colinwang2007/Shaft-Collar-Design-for-Thunderbots/Photos Shaft Collar.pdf

# Final Design CAD photos

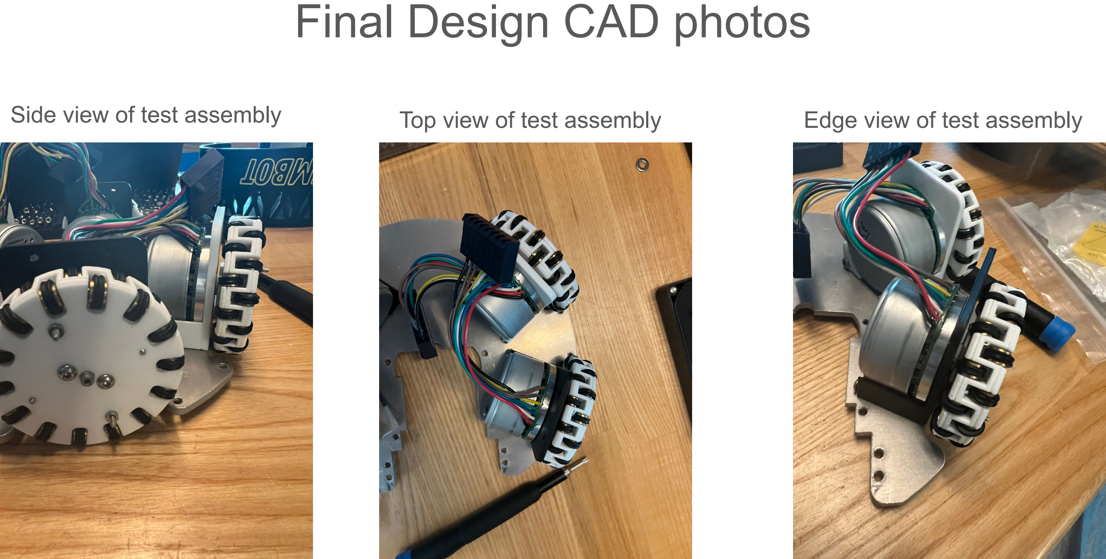
[picture p10: page 1]

Side view of test assembly | Top view of test assembly | Edge view of test assembly

# Final Design CAD photos

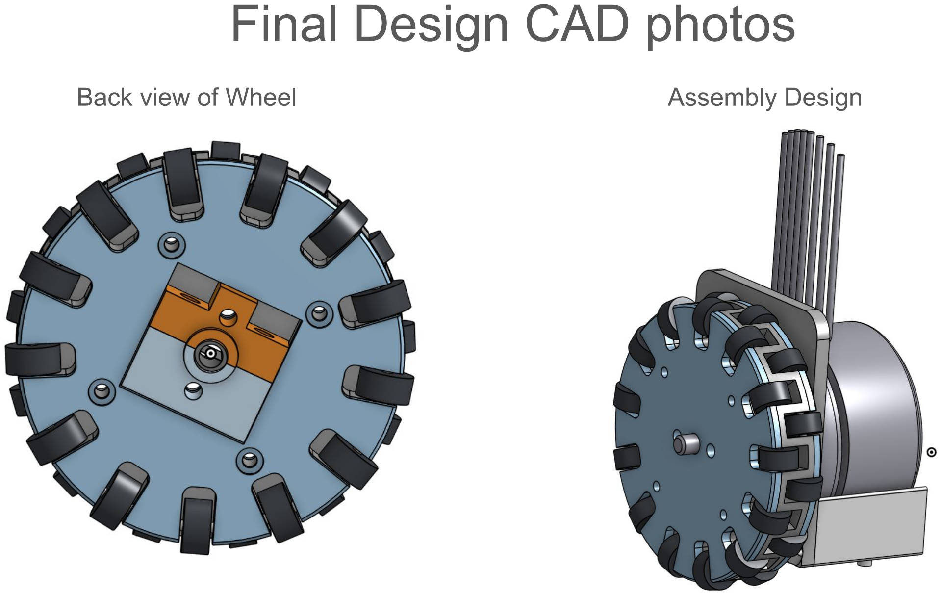
[picture p11: page 2]

Back view of Wheel

Assembly Design

# Old Design Photos

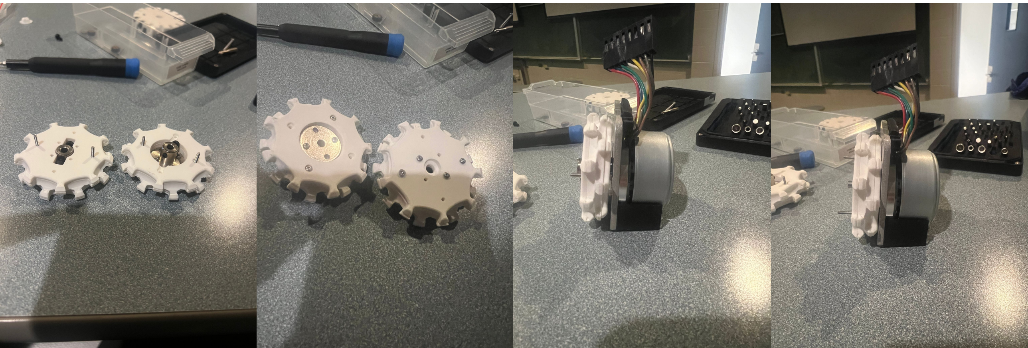
[picture p12: figure]
