colinwang2007/Shaft-Collar-Design-for-Thunderbots/CAD Models/57mm Final Wheel - Center.stl

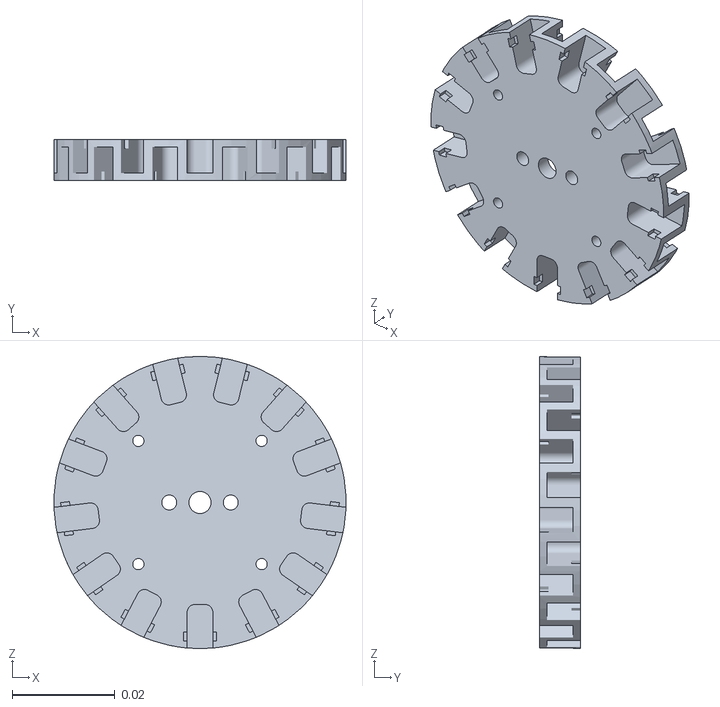
[picture p13: CAD file, 2026-03-01]
CAD Models/57mm Final Wheel - Center.stl
0.057 x 0.008 x 0.057
