colinwang2007/Shaft-Collar-Design-for-Thunderbots/CAD Models/57mm Final Wheel - Top.stl

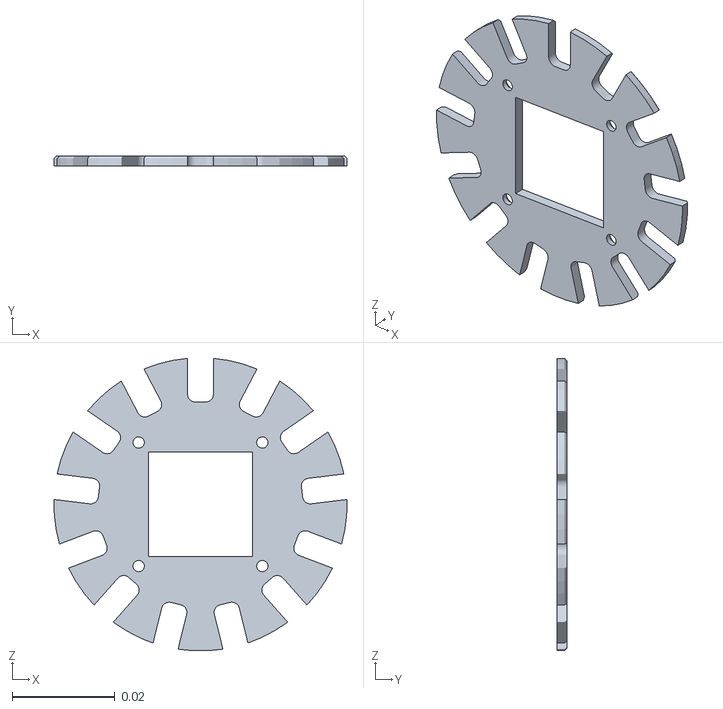
[picture p16: CAD file, 2026-03-01]
CAD Models/57mm Final Wheel - Top.stl
0.057 x 0.002 x 0.0569
