colinwang2007/Shaft-Collar-Design-for-Thunderbots/CAD Models/TPU Padding.stl

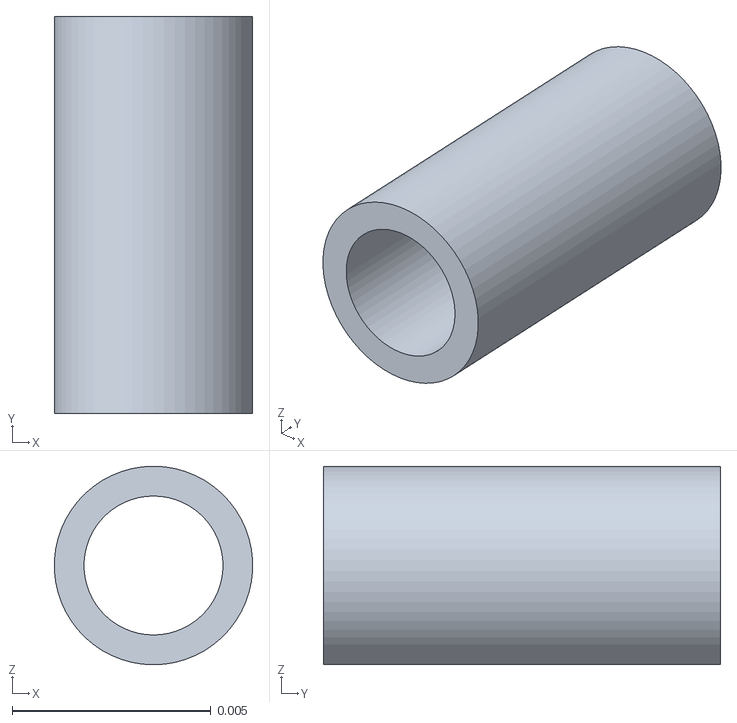
[picture p17: CAD file, 2026-03-01]
CAD Models/TPU Padding.stl
0.00499 x 0.01 x 0.005
