colinwang2007/Shaft-Collar-Design-for-Thunderbots/CAD Models/57mm Final Wheel - ScrewBlock.stl

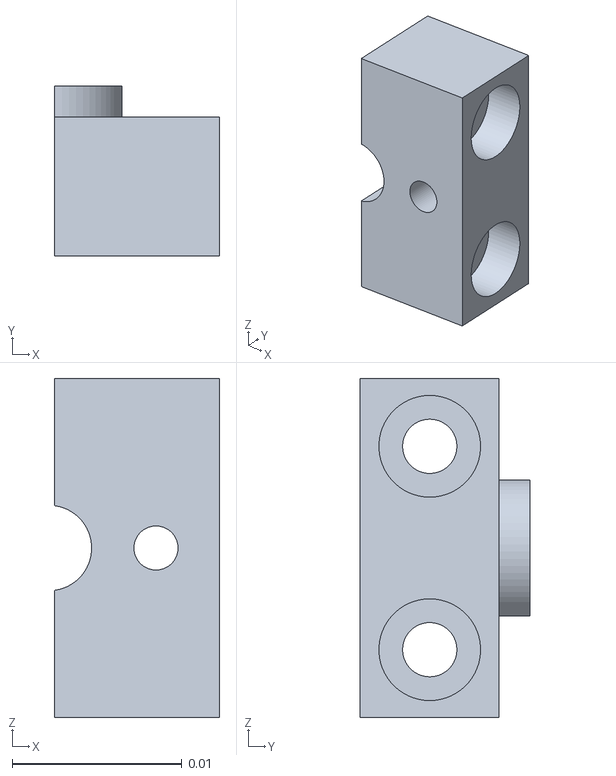
[picture p18: CAD file, 2026-03-01]
CAD Models/57mm Final Wheel - ScrewBlock.stl
0.00974 x 0.01 x 0.02
